barzamin/windpup/windpup.png

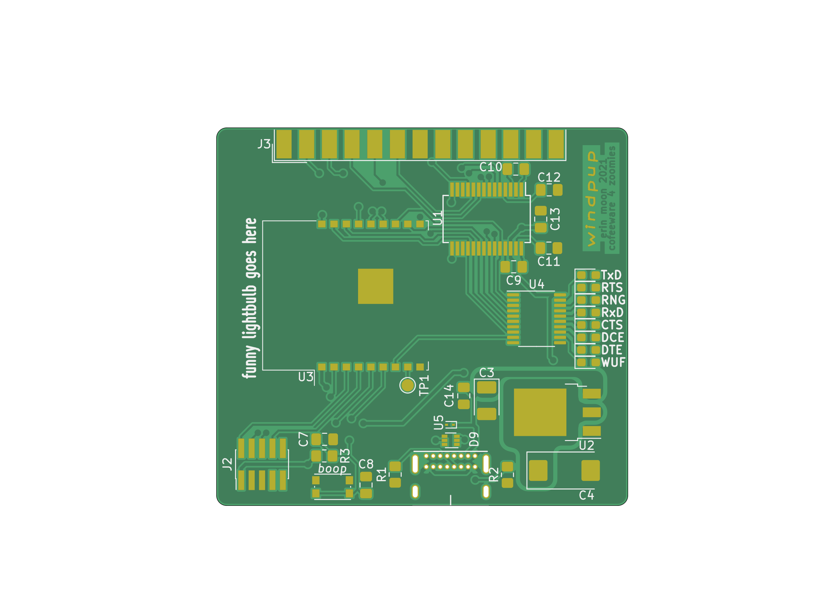
windpup.png
