barzamin/windpup/pcb/windpup/windpup.kicad_pcb

## KiCad design pcb/windpup/windpup.kicad_pcb (2021-07-23)

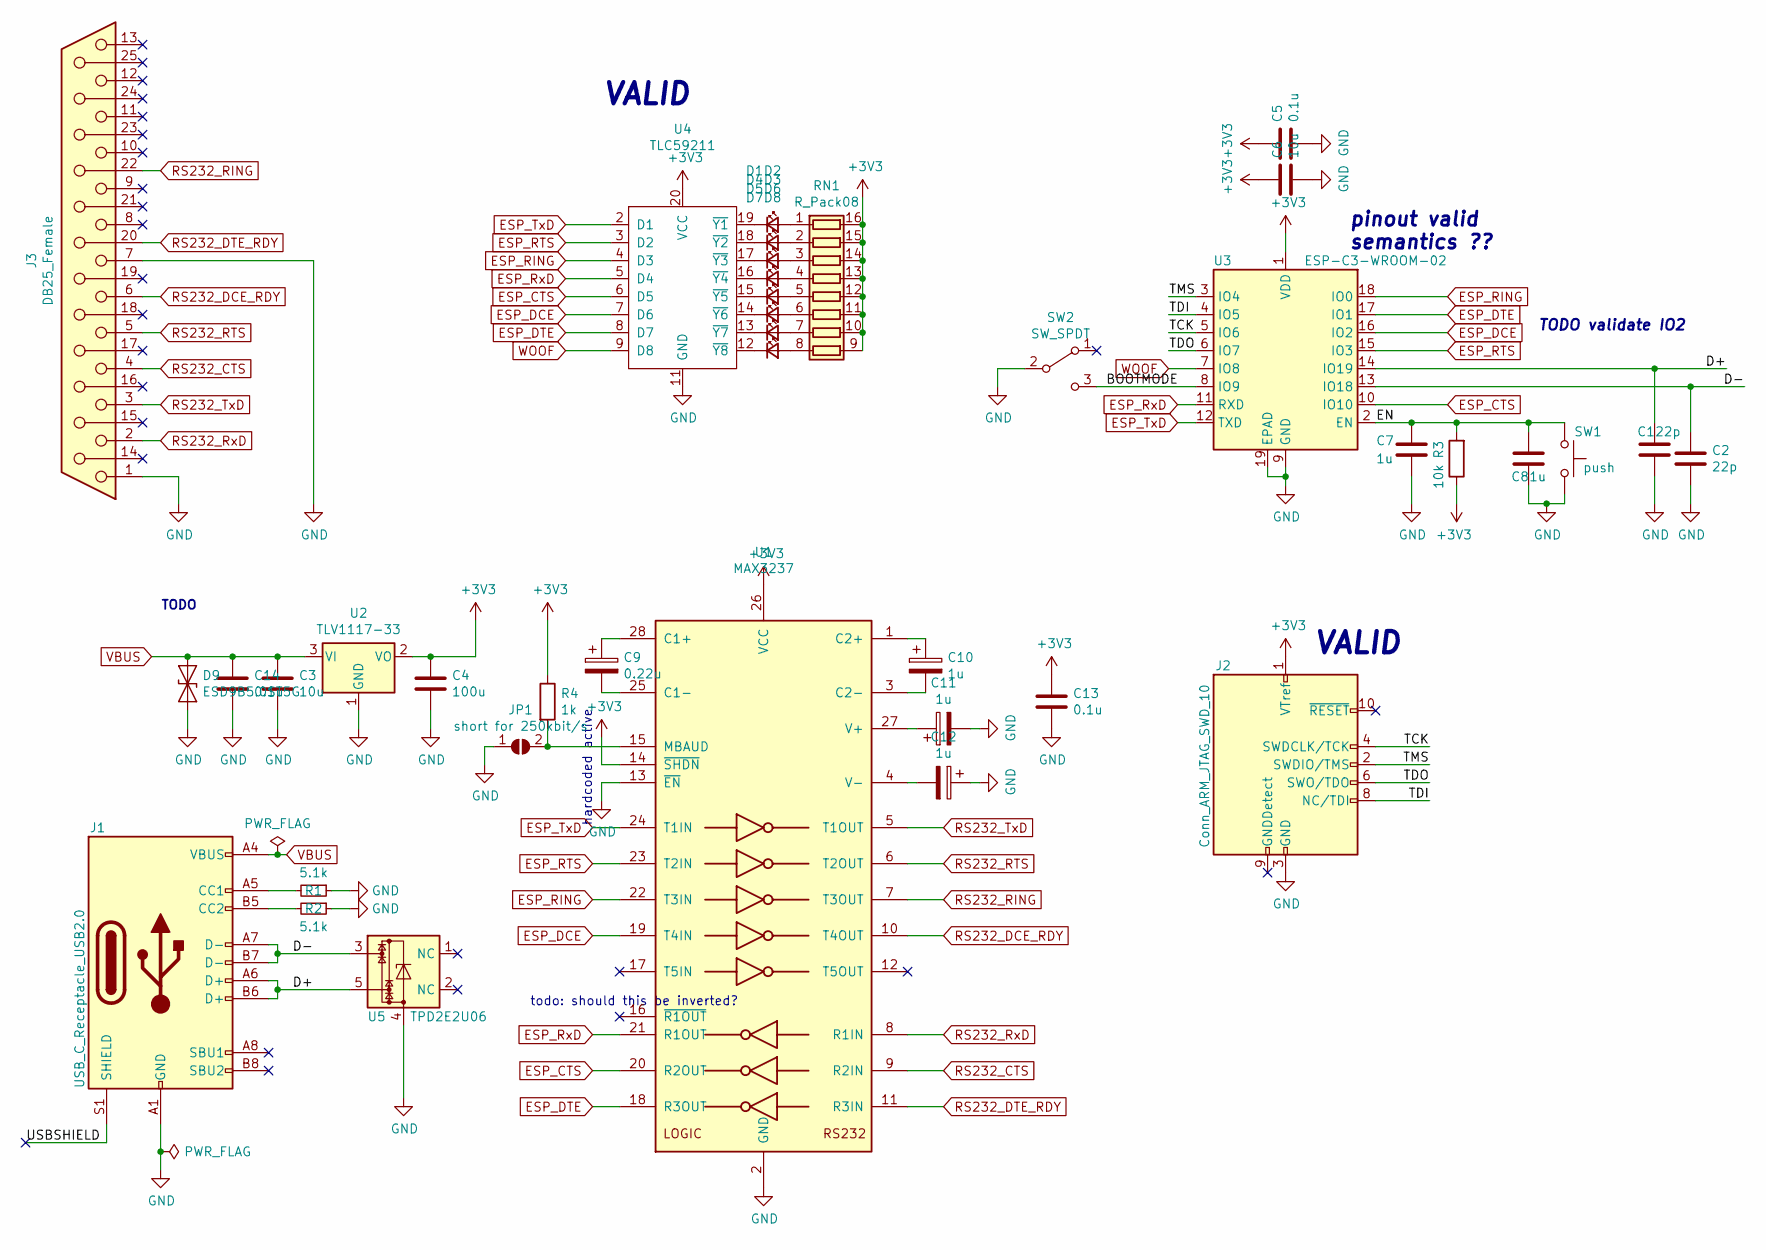
[picture p2: schematic windpup.sch]

Parts:
C1, C2: 22p; C_0805_2012Metric_Pad1.18x1.45mm_HandSolder
C3, C6: 10u; CP_EIA-3528-12_Kemet-T_Pad1.50x2.35mm_HandSolder
C4: 100u; CP_EIA-7343-31_Kemet-D_Pad2.25x2.55mm_HandSolder
C5, C13, C14: 0.1u; C_0805_2012Metric_Pad1.18x1.45mm_HandSolder
C7, C8, C10, C11, C12: 1u; C_0805_2012Metric_Pad1.18x1.45mm_HandSolder
C9: 0.22u; C_0805_2012Metric_Pad1.18x1.45mm_HandSolder
D1, D2, D3, D4, D5, D6, D7, D8: LED_Small; LED_0603_1608Metric_Pad1.05x0.95mm_HandSolder
D9: ESD9B5.0ST5G; D_SOD-923
J1: USB_C_Receptacle_USB2.0; USB_C_GCT_USB4085
J2: Conn_ARM_JTAG_SWD_10; PinHeader_2x05_P1.27mm_Vertical_SMD
J3: DB25_Female; DSUB-25_Female_EdgeMount_P2.77mm
JP1: short for 250kbit/s; SolderJumper-2_P1.3mm_Open_RoundedPad1.0x1.5mm
R1, R2: 5.1k; R_0805_2012Metric_Pad1.20x1.40mm_HandSolder
R3: 10k; R_0805_2012Metric_Pad1.20x1.40mm_HandSolder
R4: 1k; R_0805_2012Metric_Pad1.20x1.40mm_HandSolder
RN1: R_Pack08; R_Cat16-8
SW1: push; SW_Push_1P1T_NO_CK_KMR2
SW2: SW_SPDT; NidecCopal_CL-SB-12B-xx
U1: MAX3237; SSOP-28_5.3x10.2mm_P0.65mm
U2: TLV1117-33; TO-252-3_TabPin2
U3: ESP-C3-WROOM-02; ESP-WROOM-02
U4: TLC59211; TSSOP-20_4.4x6.5mm_P0.65mm
U5: TPD2E2U06; SOT-563

Connections:
+3V3: C4.1, C5.1, C6.1, C13.1, J2.1 (VTref), R3.1, R4.1, RN1.9 (R8.2), RN1.10 (R7.2), RN1.11 (R6.2), RN1.12 (R5.2), RN1.13 (R4.2), RN1.14 (R3.2), RN1.15 (R2.2), RN1.16 (R1.2), U1.14 (~SHDN), U1.26 (VCC), U2.2 (VO), U3.1 (VDD), U4.20 (VCC)
/BOOTMODE: SW2.3 (C), U3.8 (IO9)
/D+: C1.1, J1.A6 (D+), J1.B6 (D+), U3.14 (IO19), U5.5
/D-: C2.1, J1.A7 (D-), J1.B7 (D-), U3.13 (IO18), U5.3
/EN: C7.1, C8.1, R3.2, SW1.1, U3.2 (EN)
/TCK: J2.4 (SWDCLK/TCK), U3.5 (IO6)
/TDI: J2.8 (NC/TDI), U3.4 (IO5)
/TDO: J2.6 (SWO/TDO), U3.6 (IO7)
/TMS: J2.2 (SWDIO/TMS), U3.3 (IO4)
/USBSHIELD: J1.S1 (SHIELD)
ESP_CTS: U1.20 (R2OUT), U3.10 (IO10), U4.6 (D5)
ESP_DCE: U1.19 (T4IN), U3.16 (IO2), U4.7 (D6)
ESP_DTE: U1.18 (R3OUT), U3.17 (IO1), U4.8 (D7)
ESP_RING: U1.22 (T3IN), U3.18 (IO0), U4.4 (D3)
ESP_RTS: U1.23 (T2IN), U3.15 (IO3), U4.3 (D2)
ESP_RxD: U1.21 (R1OUT), U3.11 (RXD), U4.5 (D4)
ESP_TxD: U1.24 (T1IN), U3.12 (TXD), U4.2 (D1)
GND: C1.2, C2.2, C3.2, C4.2, C5.2, C6.2, C7.2, C8.2, C11.2, C12.1, C13.2, C14.2, D9.2 (A2), J1.A1 (GND), J1.A12 (GND), J1.B1 (GND), J1.B12 (GND), J2.3 (GND), J2.5 (GND), J3.1, J3.7, JP1.1 (A), R1.1, R2.1, SW1.2, SW2.2 (B), U1.2 (GND), U1.13 (~EN), U2.1 (GND), U3.9 (GND), U3.19 (EPAD), U4.11 (GND), U5.4
unnamed: C9.1, U1.28 (C1+)
unnamed: C9.2, U1.25 (C1-)
unnamed: C10.1, U1.1 (C2+)
unnamed: C10.2, U1.3 (C2-)
unnamed: C11.1, U1.27 (V+)
unnamed: C12.2, U1.4 (V-)
unnamed: D1.1 (K), U4.19 (~Y1)
unnamed: D1.2 (A), RN1.1 (R1.1)
unnamed: D2.1 (K), U4.18 (~Y2)
unnamed: D2.2 (A), RN1.2 (R2.1)
unnamed: D3.1 (K), U4.17 (~Y3)
unnamed: D3.2 (A), RN1.3 (R3.1)
unnamed: D4.1 (K), U4.16 (~Y4)
unnamed: D4.2 (A), RN1.4 (R4.1)
unnamed: D5.1 (K), U4.15 (~Y5)
unnamed: D5.2 (A), RN1.5 (R5.1)
unnamed: D6.1 (K), U4.14 (~Y6)
unnamed: D6.2 (A), RN1.6 (R6.1)
unnamed: D7.1 (K), U4.13 (~Y7)
unnamed: D7.2 (A), RN1.7 (R7.1)
unnamed: D8.1 (K), U4.12 (~Y8)
unnamed: D8.2 (A), RN1.8 (R8.1)
unnamed: J1.A5 (CC1), R1.2
unnamed: J1.B5 (CC2), R2.2
unnamed: JP1.2 (B), R4.2, U1.15 (MBAUD)
RS232_CTS: J3.4, U1.9 (R2IN)
RS232_DCE_RDY: J3.6, U1.10 (T4OUT)
RS232_DTE_RDY: J3.20, U1.11 (R3IN)
RS232_RING: J3.22, U1.7 (T3OUT)
RS232_RTS: J3.5, U1.6 (T2OUT)
RS232_RxD: J3.2, U1.8 (R1IN)
RS232_TxD: J3.3, U1.5 (T1OUT)
VBUS: C3.1, C14.1, D9.1 (A1), J1.A4 (VBUS), J1.A9 (VBUS), J1.B4 (VBUS), J1.B9 (VBUS), U2.3 (VI)
WOOF: U3.7 (IO8), U4.9 (D8)

Notes on the sheet:
TODO
hardcoded active
todo: should this be inverted?
VALID
pinout valid semantics ??
TODO validate IO2

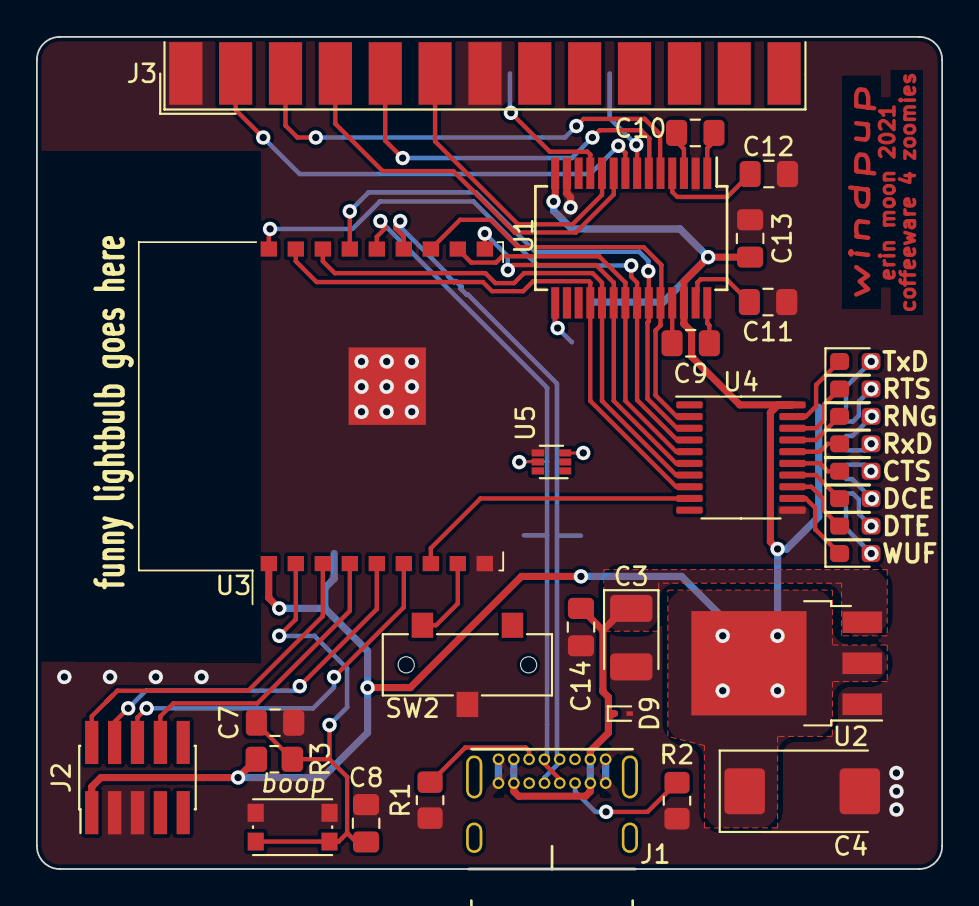
[picture p3: board windpup.kicad_pcb from above]

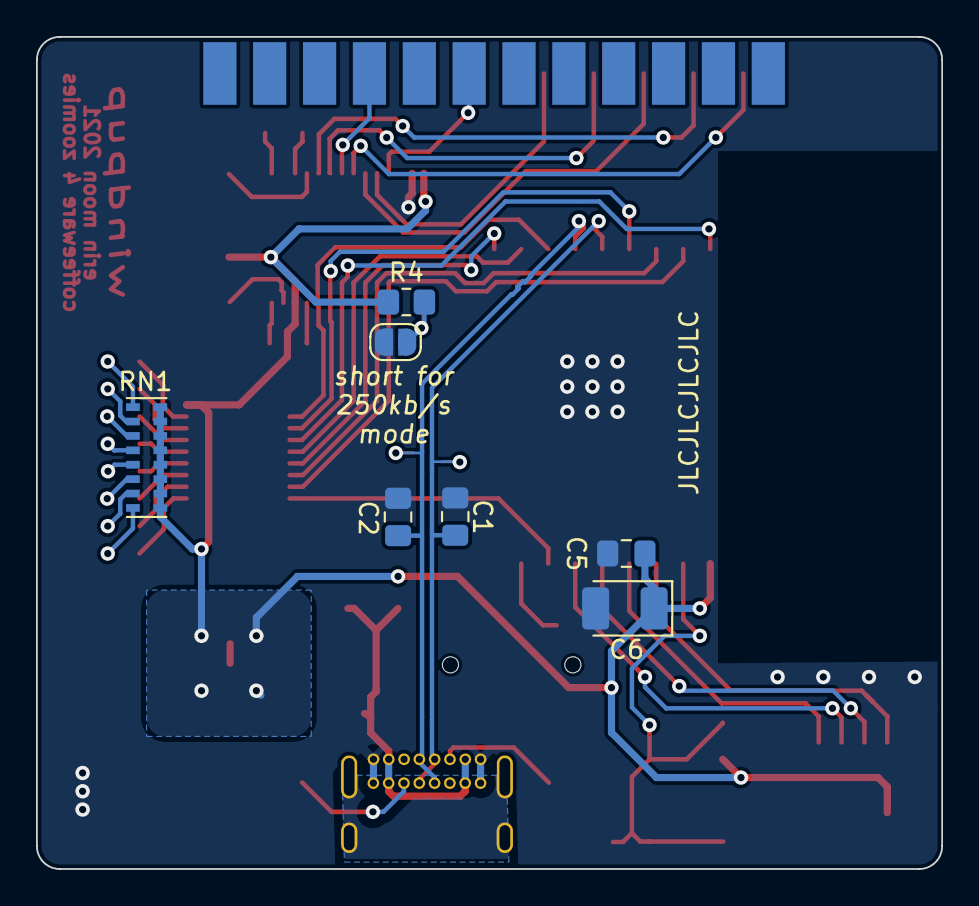
[picture p4: board windpup.kicad_pcb from below]

Board: 2 copper layers, 50.3 x 46.2 mm, 39 parts (7 on the bottom side), 51 nets.
