barzamin/windpup/(commit log)

2021-07-03 initial version
    [windpup.kicad_pcb, windpup.sch]
2021-07-23 pcb: update for manuf
    [dk-bom.csv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]
2021-07-23 add boardrender
2021-08-06 socket connection code
